Coupe-de-France-de-robotiques/tournament-ggdrive/Rendus/Rapport final info/Asservissement.docx

1. Asservissement
  i. Principe de l’asservissement

Lorsque l’on souhaite faire avancer un robot, on ne peut transmettre à celui-ci qu’une seule consigne. Idéalement, si le système est parfait et que l’on sait exactement une telle tension donne une telle vitesse, une seule consigne peut être suffisante pour avancer le robot. Mais la réalité, en raison de la perturbation et de l’imperfection du système, les erreurs sont sûrement garanties. Afin de résoudre ce problème et de réduire les erreurs produites, il y a besoin d’avoir un retour sur la consigne transmise. On a donc besoin des capteurs pour mesurer la sortie et envoyer le retour, qui permet d’ajuster la consigne correspondant pour corriger les erreurs.

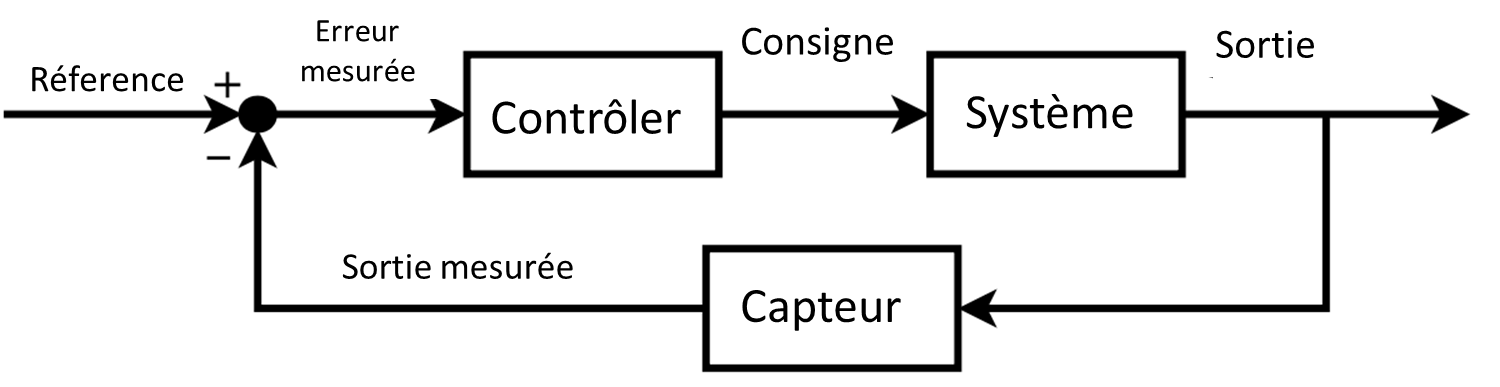
[picture p18: figure]

Figure 1- Pincipe d'un asservissement

Dans notre cas, on souhaite contrôler les deux moteurs du robot avec la carte Arduino et les encodeurs qui permet de mesurer la position du robot. Notre intérêt est de faire avancer le robot tout droit et de faire tourner le robot.

  ii. Présentation des matériels
    a. La carte Arduino

Nous utilisons la carte Arduino MEGA afin d’asservir le déplacement du robot car elle dispose de très nombreux pins d’entrée-sortie. En effet, elle dispose de six pins digitaux qui permettent d’utiliser la fonction « Interrupt » utilisée pour faire tourner tout le temps les encodeurs, alors que l’Arduino UNO ne dispose que deux de ces pins. Il nous donc reste de ces pins pour servir les autres capteurs qui ont besoin.

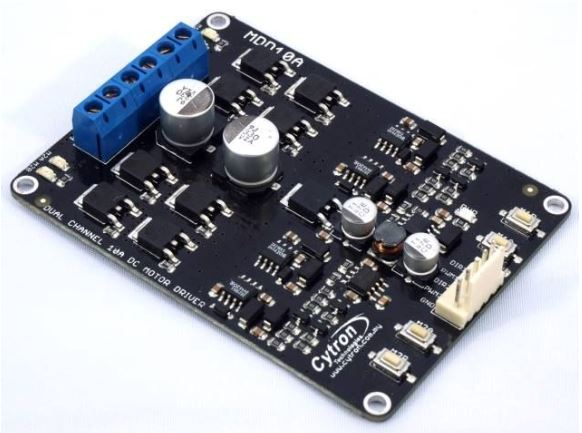
[picture p19: figure]
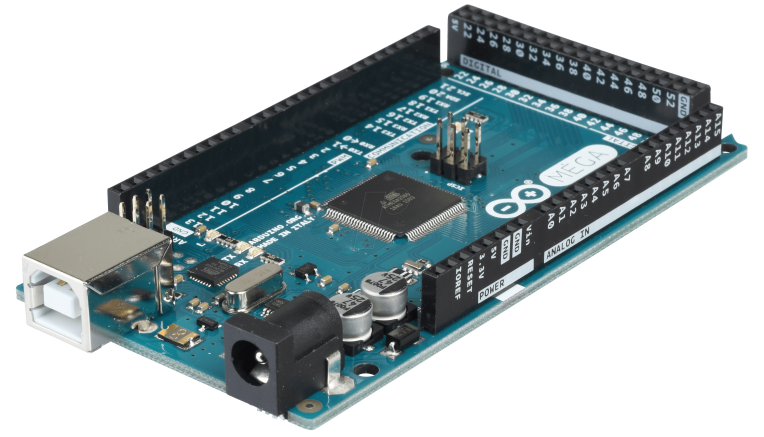
[picture p20: figure]

Figure 2: la carte puissance MDD10A

Figure 3 : Arduino MEGA

On se rend compte d’utiliser la carte Arduino pour réaliser l’asservissement, mais la sortie PWM de l’Arduino de 0 à 5V est très faible pour contrôler le moteur de 12 V. On a donc besoin un circuit intermédiaire pour augmenter la tension sortie et aussi prévenir le courant induit par le moteur. Le circuit mentionné n’a pas été fait car on a trouvé une autre solution plus simple, c’est d’utiliser une carte puissance (MDD10A) de Cytron Technologies (figure 2).

    b. Moteurs

Le bon choix des moteurs est un point important dans la réalisation d'un robot. En effet si les moteurs n'ont pas assez de couple, il sera très difficile pour le robot de se mouvoir à faible vitesse, de démarrer ou même de freiner efficacement. Si la vitesse de rotation est trop faible, le robot sera lent, si le moteur est sous-dimensionné il sera utilisé en surrégime, ce qui peut être bénin pour une utilisation de courte durée comme critique si l'utilisation est en fait trop violente et entraîner la fonte de la gaine du bobinage et donc la destruction du moteur.

Après étudier les caractéristiques du moteur de la marque suisse « Maxon Motors » qui est réputé pour sa robustesse, le groupe Méca a décidé de l’utiliser pour notre robot.

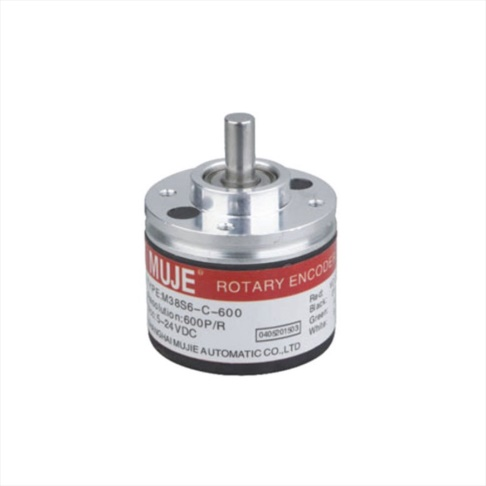
[picture p21: figure]
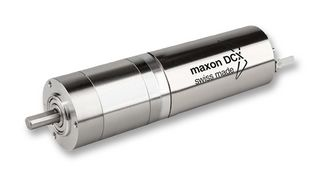
[picture p22: figure]

Figure 4 : Encodeur

Figure 5 : Moteur Maxon

    c. Encodeur séparé

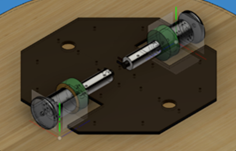
[picture p23: figure]

Pour optimiser l’odométrie, nous avons décidé rapidement de séparer la motricité de l’encodage du mouvement comme la figure ci-dessous pour s’affranchir du compromis adhérence-précision (la roue motrice veut avoir une grande surface de contact tandis qu’une roue codeuse optimale souhaite un contact ponctuel).

Figure 6 : La structure de la base du robot

  iii. Asservissement
    a. Localisation

À part de la caméra, le positionnement peut se faire à partir des encodeurs. C’est le positionnement relatif, on met à jour la position du robot à chaque petit pas du temps, à partir de la position précédente du robot.

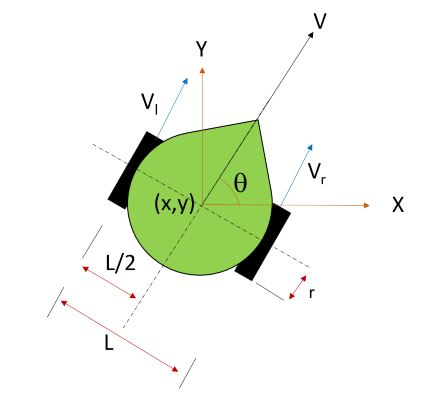
[picture p24: figure]
Capture

Le modèle qu’on a utilisé, c’est le modèle du robot mobile à roues différentielles.

Figure 7 : modèle du robot

{, x=vcos(θ), y=vsin(θ), θ=ω et {, v=1/2(v_r +v_l ), θ=1/L(v_r -v_l )

Il nous donc donne la position et l’orientation du robot par :

{, x(t+Δt)≈x(t)+(dx)/(dt) Δt=x(t)+1/2(v_r +v_l )Δt cos⁡(θ), y(t+Δt) ≈y(t)+(dy)/(dt) Δt=y(t)+1/2(v_r +v_l )Δtsin(θ), θ(t+Δt)≈θ(t)+(dθ)/(dt) Δt=θ(t)+1/L(v_r -v_l )Δt

Comme Δt est petit, v_r Δt et v_l Δt sont le déplacement de la roue droite et gauche respectivement ( d_r , d_l ).

On a donc {, x(t+Δt)=x(t)+1/2(d_r +d_l )cosθ, y(t+Δt)=y(t)+1/2(d_r +d_l )sinθ, θ(t+Δt)=θ(t)+1/L(d_r -d_l )

d_r et d_l = le déplacement par « tick » × un écart de nombre de ticks en Δt

L’implémentation du positionnement du robot n’est pas très compliquée, il suffit de mettre à jour les équations à chaque petit pas du temps.

    b. Implémentation du PID

Notre asservissement est un asservissement en position, en effet, nous ne cherchons pas à contrôler la vitesse de déplacement du robot mais uniquement sa position afin qu’il parcoure exactement la distance souhaitée en ligne droite et qu’il tourne exactement vers l’orientation souhaitée.

Le principe du PID (Proportionnel, intégrale, dérivée) est de comparer à la fois la sortie et l’entrée (reference) afin d’observer l’évolution de l’erreur et de le corriger avec la consigne qui est formée par trois composantes :

- Composante proportionnel : elle génère une valeur proportionnelle aux erreurs mesurées. Si l’erreur est importante, il faut aussi appliquer une correction importante afin de converger vers la valeur voulue. Mais quand on demande plus de rapidité (composante proportionnel est grande), le système est sensible à l’oscillation et il ne converge pas vers la valeur voulue.
- Composante dérivée : elle permet d’améliorer la stabilité du système en diminuant les oscillations. En effet, elle donne une valeur proportionnelle à l’évolution de l’erreur au cours du temps.
- Composante intégrale : elle permet de gagner en précision en empêchant la formation d’une erreur statique. Lorsqu’il n’y a pas de changement de l’erreur au cours du temps, les composantes proportionnelle et dérivée donnent uniquement zéro. Afin d’éviter ce phénomène, la somme des erreurs au cours du temps nous permet de pousser la convergence du système vers la valeur voulue.

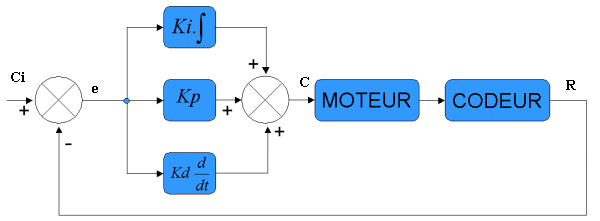
[picture p25: figure]

Figure 8 : Schéma PID

Comme indiqué plus haut, le modèle du robot nous donne :

{, v=1/2(v_r +v_l ), ω=1/L(v_r -v_l ) ou bien {, v=r/2(ω_r +ω_l ), ω=r/L(ω_r -ω_l )

ω_r et ω_l sont la vitesse angulaire du moteur droite et gauche.

On a donc {, ω_r =1/r(2v+Lω) , ω_l =1/r(2v-Lω)

À partir de ces équations, les consignes envoyées au moteur droite et gauche sont déterminées par la vitesse de déplacement et la vitesse angulaire du robot.

- Pour faire tourner le robot à l’angle souhaité, la vitesse de déplacement du robot doit être zéro. Il ne nous reste que de gérer la vitesse angulaire.

C’est à partir d’ici, on va implémenter le PID. On va suivre ces étapes :

  - Mesurer l’orientation du robot
  - Mesurer l’erreur en angle par rapport à l’angle désiré
  - Former une correction de trois composantes

ω= K_p erreurAngle+K_d (d(erreurAngle))/(dt)+K_i ∫erreurAngle(t)dt

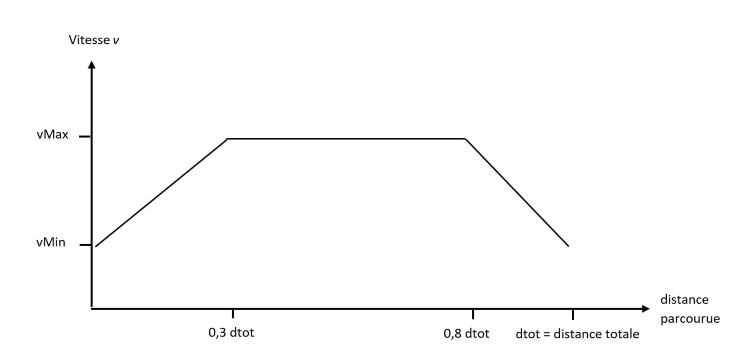
[picture p26: figure]

- Pour faire avancer le robot en ligne droite, l’orientation du robot doit être zéro ; ω est déterminée par le PID de l’angle souhaité zéro. Cependant, la vitesse de déplacement est déterminée de la manière indiquée dans la figure ci-dessous, elle augmente en rampe au début, descend en rampe à la fin et reste constant au milieu du trajet.

Figure 9 : la fonction de vitesse au cours du temps

Réglage des constantes K_p , K_d , K_i

On va se servir la méthode de Ziegler-Nichols pour régler les constantes du PID. Afin d’obtenir K_p , K_d ,K_i , il nous faut d’abord cherche le gain maximal K_u en mettant K_i et K_d en zéro et en réglant K_p jusqu’à ce que le système s’oscille de manière stable. Ensuite, on repère la période d’oscillation T_u . On a donc le réglage correspondant :

{, K_p =0,6K_u , K_d =3K_u T_u /40, K_i =1,2K_u /T_u
