Coupe-de-France-de-robotiques/tournament-ggdrive/Rendus/Presentation finale info/Document sans titre.docx

Organigramme

Pourquoi Arduino + raspberry ?

Organisation du robot

Choix de l’algo (Demo)

Cam (demo)

Asservissement (demo)

Conclusion

Guillaume

Kim hong

Aurélien

Ayoub
