Coupe-de-France-de-robotiques/tournament-ggdrive/Rendus/Presentation finale info/Présentation sans titre.pptx

## Choix des cartes

1 carte Arduino reliée au cœur du robot
2 cartes Raspberry Pi : une dans le robot, l’autre reliée à la caméra

## Pourquoi Arduino ?

Pratique à utiliser
Facile d’interagir avec les autres composants
Adapté à la robotique

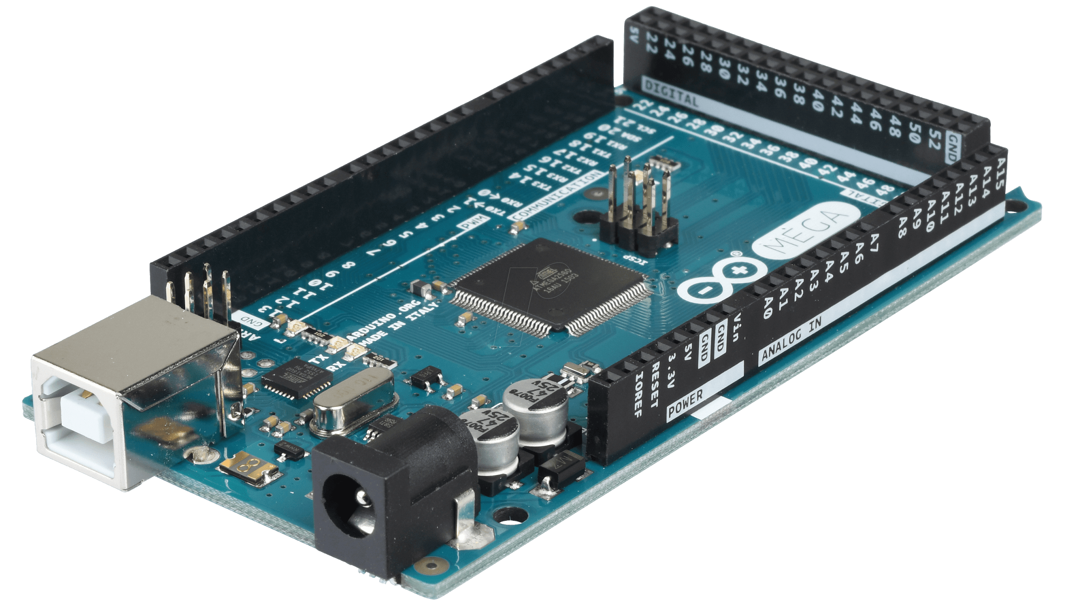
[picture p40: figure]

## Pourquoi Raspberry Pi ?

Calculs lourds et en parallèle
Compatibilité de caméra
Communication inter-cartes

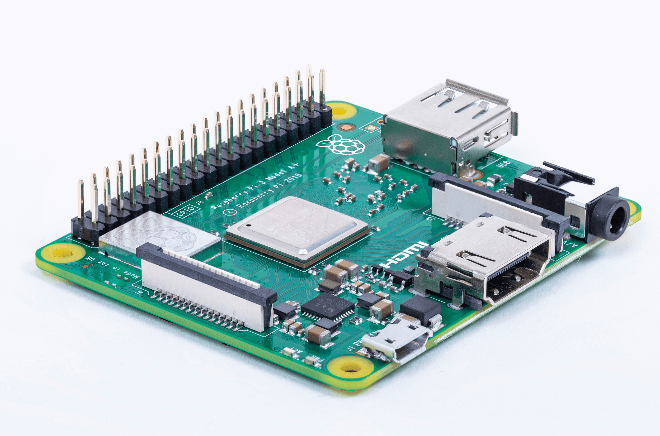
[picture p41: figure]

## Organisation du robot

Robot

Bloc caméra

Raspberry Pi

Caméra

Arduino

Raspberry Pi

Moteurs

Roues encodeuses

Capteurs ultrasons

## Conclusion
