Coupe-de-France-de-robotiques/tournament-ggdrive/Rendus/Rapport final info/Plan.docx

Total de pages: entre 30 et 40

Nombre de pages à titre indicatif (essayez d’en faire au moins les ⅔), sans les images.

Par ailleurs, la notation prend en compte les références bibliographiques ; si vous pouvez indiquer où une référence est utilisée dans votre texte, c’est positif.

Intro 1 page

Présentation du groupe & organisation 2 pages Aurélien

Exotec 6 pages Aurélien

Robot 1 page (à pomper sur la méca)

Cerveau 10 pages Ayoub

Asservissement 5 pages Kimhong

Caméra 5 pages Guillaume

Conclusion 1 page

Références & remerciements balancez tout
