Coupe-de-France-de-robotiques/tournament-ggdrive/Ressources - matériel/Ressources.docx

Au niveau de ce qu’on a utilisé et sur quoi vous pouvez vous pencher:

- Partie info
  - Cartes arduino, c’est assez facile à utiliser, on apprend les bases assez vite et on trouve beaucoup de doc pour tout ce dont on a besoin. Pour commencer par quelque-chose, vous pouvez regarder le tuto https://openclassrooms.com/courses/programmez-vos-premiers-montages-avec-arduino
  - Raspberry pi : Si vous voulez faire un robot plus intelligent, c’est un passage obligé. La raspberry c’est un ordinateur complet sur une seule carte, et ça tourne sous Linux. Pour pouvoir utiliser ça il y a pas 36 solutions, il faut maîtriser Linux. À tout le groupe qui s’occupe de l’info, je vous recommande très fortement de suivre ce tuto (en entier si possible) https://openclassrooms.com/courses/reprenez-le-controle-a-l-aide-de-linux/mais-c-est-quoi-linux Si vous voulez faire un peu d’info plus tard (que ça soit en parcours info, map, méca ou autre…) vous en aurez besoin, c’est un passage obligé. C’est pas trés dur il faut juste prendre un peu l’habitude, pour ça je vous recommande de faire un dual boot, c’est très pratique mais si vous préférez vous pouvez juste utiliser une machine virtuelle (voir tuto). Je vous conseille d’utiliser ROS, on a pas eu l’occasion de s’y pencher mais c’est vraiment top, on me l’a conseillé à de nombreuses reprises :https://fr.wikipedia.org/wiki/Robot_Operating_System ou encore http://wiki.ros.org/ Pas besoin de regarder ça tout de suite, ça peut attendre la rentrée, commencez par Linux ^^
  - Git, c’est un outil de versionning, ça permet de travailler sur un projet informatique à plusieurs. C’est vraiment un standard qu’on utilise partout (même si il en existe d’autre). Pareil, commencez par Linux, on verra ça plus tard.
- Partie méca
  - Pour tout ce qui est modélisation, Fusion 360 est pas mal. Contrairement à Solid Works, c’est facile d’avoir une licence gratuite en étant étudiant (https://www.autodesk.com/products/fusion-360/students-teachers-educators?td=aexfusion&displ=1). Essayez de commencer à prendre le logiciel en main, à regarder quelque tutos et à essayer de faire des formes (genre, modélisez votre lampe de bureau par exemple)
  - Il faut absolument faire la formation machine (découpe laser et imprimante 3D) c’est vos outils principaux pour construire le robot.
  - Quand vous avez besoin de matos (à condition d’avoir le budget…) cherchez du côté de robotshop: https://www.robotshop.com/eu/fr/ de RS https://fr.rs-online.com/web/ (c’est chez eux qu’il faut regarder pour les commandes avec le Fablab, qui donne un peu d’argent chaque année). Ou encore chez Amazon
- Bricolage de manière générale (édit Maxime Escande)
  - https://www.youtube.com/user/monsieurbidouille chaîne Youtube qui explique les différents logiciels de modélisation 3d, l'impression 3d, ...
