Coupe-de-France-de-robotiques/tournament-ggdrive/Rendus/Prés Prop Dét/Présentation Proposition détaillée.docx

!!!!!!!!!J’ai mis une version avec trois slides en plus en pptx à côté mais je ne sais pas comment refaire le coup du document en ligne comme yahia avait fait (Pour toute réclamation sur le fait que l’on ne puisse plus modifier le document à plusieurs, ben faut le remettre en ligne mais je ne sais vraiment pas comment…(Julien) )

https://epolytechnique-my.sharepoint.com/:p:/g/personal/yahya_iben-brahim_polytechnique_edu/EbK5ZoKXDBFKoMHUUOfnzHgBao6ZR1P9KX-HfSzw_p0nxA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
