Coupe-de-France-de-robotiques/tournament-ggdrive/Rendus/Prés Prop Dét/PrésentationPropDét.pptx

## PROJET SCIENTIFIQUE COLLECTIF


PROPOSOTIon detailleÉ

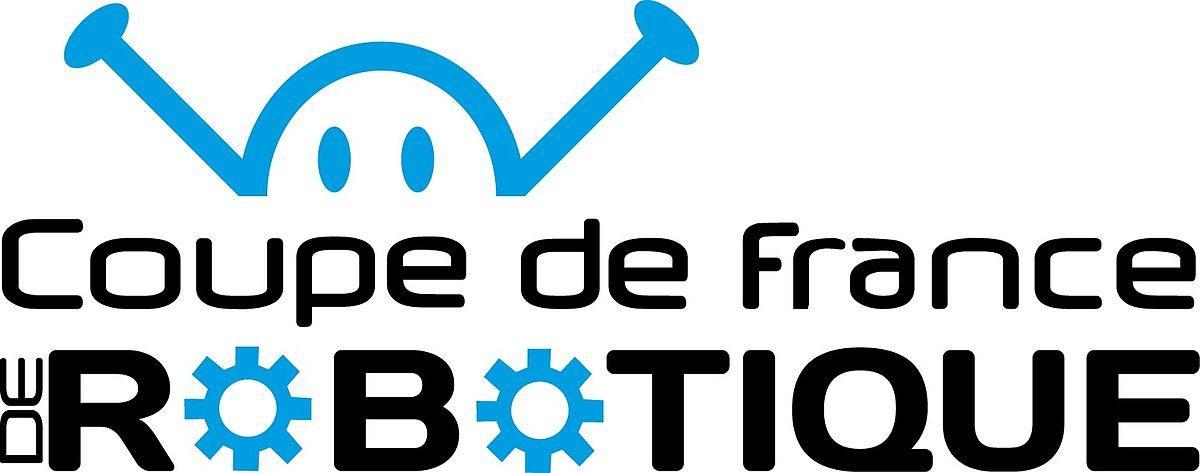
[picture p57: figure]
Une image contenant graphiques vectoriels Description générée avec un niveau de confiance élevé

## Groupe mec 11

- AGIER Julien
- COLSON Raphaël
- CHAQUIQ ELBADRE Hamza
- ESCANDE Maxime
- IBEN BRAHIM Yahya
TUTEUR: SOUVESTRE Florent
COORDINATEUR: BODELOT Laurence

En collaboration avec le groupe INF 09

## Sommaire

- 1) Présentation du Projet
- 2) Enjeux et motivation
- 3) Règlement de la coupe
- 4) Organisation
- 5) Avancement et planning prévisionnel
- 6) Moyens et financement

## 1) PROJET

- Coupe de France de robotique : Mai 2019
- Thème 2019 : ATOM FACTORY
- Conception et réalisation d'un robot capable de marquer le maximum de points.

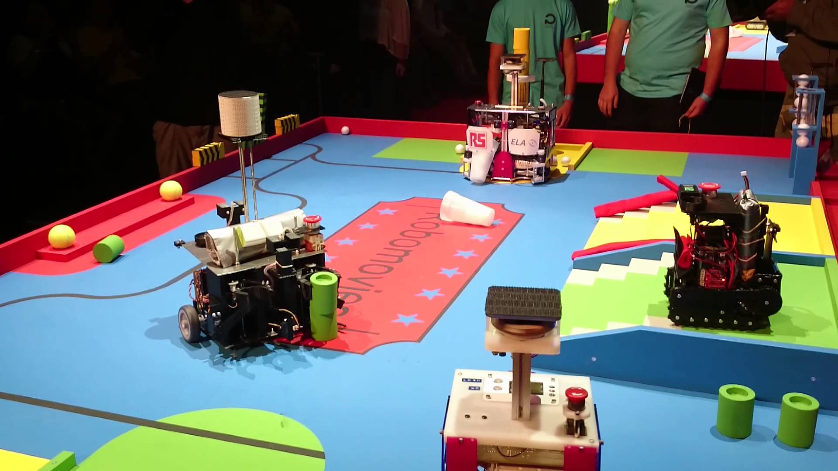
[picture p58: figure]
Une image contenant intérieur, table, gâteau, personne Description générée avec un niveau de confiance élevé

## 2) Enjeux et motivation

- Suivre une démarche industrielle

- Objectif du groupe: réalisation d'un robot transmissible aux générations futures :
    - Base mobile fiable
    - Actionneurs modulables

Cahier de charges
Reformulation technique
Répartition en pôles

- Projet concret et ludique

## 3) RÈGLEMENT DE LA COUPE 2019

- L'aire de jeu
- Les éléments du jeu : les Atomes
- Missions Atom Factory
- Notre stratégie

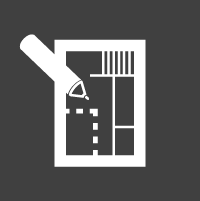
[picture p59: figure]

## L'aire de jeu

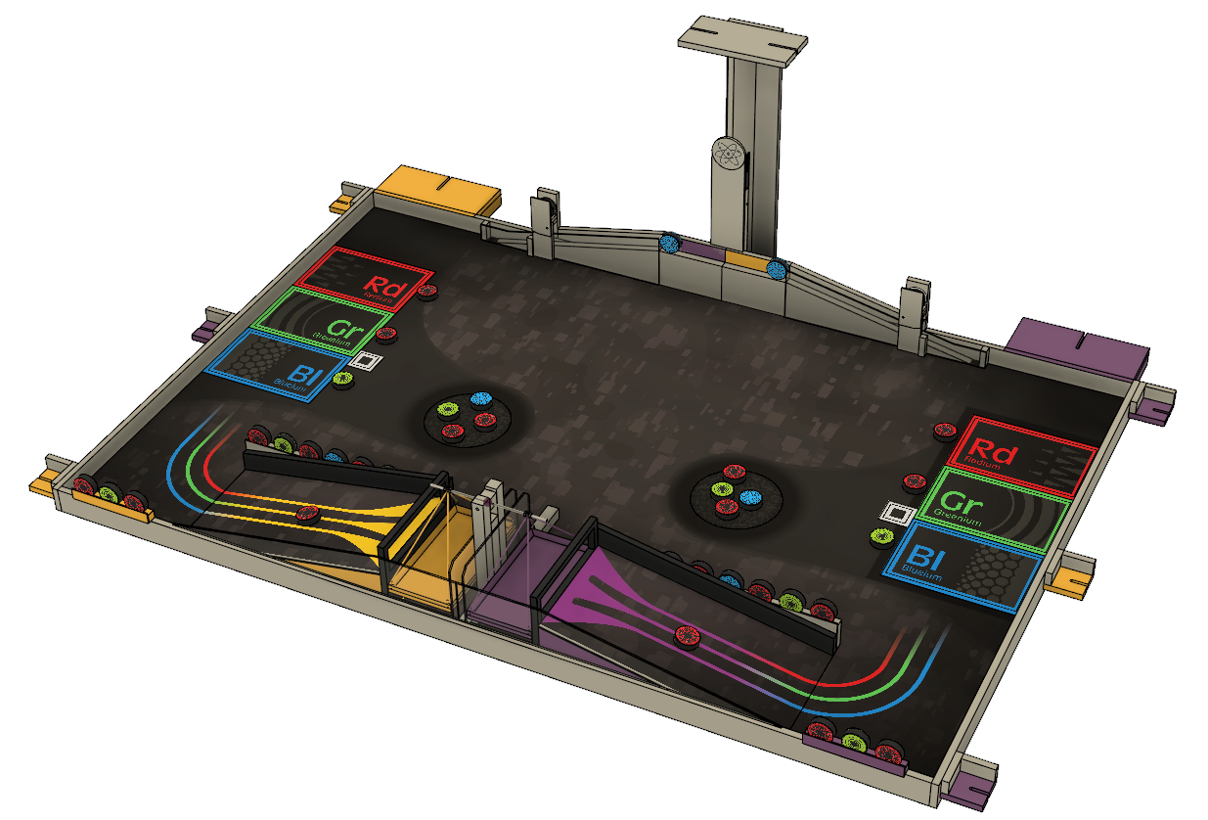
[picture p60: figure]
Une image contenant intérieur, assis Description générée avec un niveau de confiance très élevé

## Les éléments du jeu : les Atomes

Les atomes sont représentés par des palets de hockey

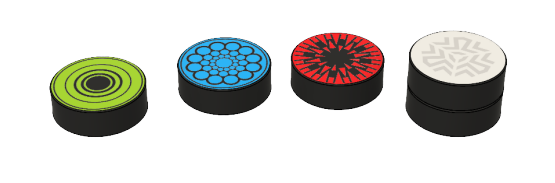
[picture p61: figure]
Une image contenant casino, pièce Description générée avec un niveau de confiance très élevé

Blueium 170g

Redium 60g

Goldenium 340g

Greenium 120g

## Missions Atom Factory

- Classer les atomes
- Peser les atomes
- Créer un nouvel élément
- Faire sa propre expérience
- Prédire les éléments non connus

## Notre stratégie

- Tâche principale : base mobile fiable
- Choix des missions les plus simples qui rapportent le plus de points :
- L'exprérience
- Créer un nouvel élément (récupérer le goldenium)
- Prédir le score
- Missions secondaires : classer les atomes.

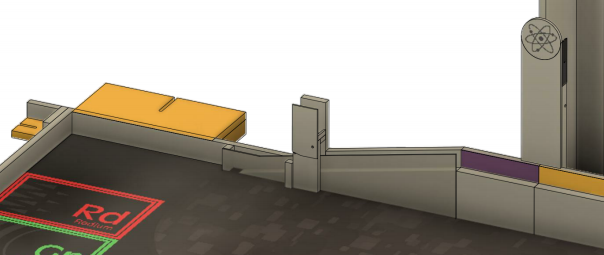
[picture p62: figure]
Une image contenant plancher, intérieur, meubles, mur Description générée avec un niveau de confiance très élevé
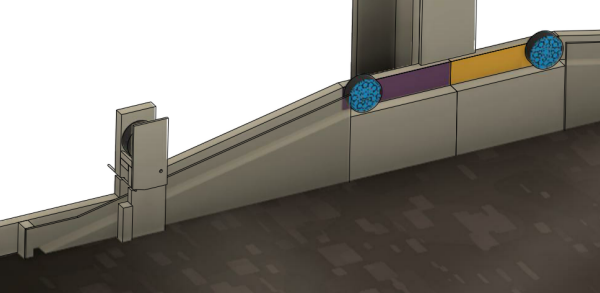
[picture p63: figure]
Une image contenant plancher, intérieur, mur, ciel Description générée avec un niveau de confiance très élevé

## 4) Organisation

Structure 3D

Maxime
Coordinateur

Dimensionnement et motorisation

Julien
Resp. Administratif
Hamza
Secrétaire général

Capteurs

Yahya
Trésorier
Raphaël
Resp. sponsors

## Dimensionnement et motorisation

- v_(min) = 0.5 m/s atteignable en 1s
Avec m≈6kg , R_w ≈4cm
C_w ≥maR=1,2 10^(−1) Nm
ω_w ≥v/R=1,9 2π rad s^(−1)
- Compromis moteur réducteur ( σ ratio) :
C_w ω_w =C_m ω_m
σ=(ω_w)/(ω_m)

## Précision d’encodage

  - Rotation de θ et avancée de L
  - ε(L)=2dL=2Ru(α)
  - ε(θ)=Lu(θ)≈R/l Lu(α)θ
θ=R/lα, so (u(θ))/θ=√((α/R)^2 u(R)²+((Rα)/(l^2))^2 u(l)²+(R/l)^2 u(α)²)
→Grand déplacement, l’erreur vient des rotations
  - Déplacement type de la coupe : 2m et demi-tour cinq fois
  - Erreur inférieure à 5cm si:
u(α)≈5/5 15/(3∗200∗π)=2π 1/400

## Choix structurels

- Une structure simple et fiable
- appuie ponctuel dilemme précision /accélération

Avant

Roues motrices

Arrière

Roues encodeuses

Roues libres : asssurent la stabilité

## Dimensionnement et motorisation

- CALCUL
- EQUATION
- CALCUL
- EQUATION

## 5) Avancement et planning prévisionnel

Sortie des règles

Aujourd'hui
Proposition détaillée

Budget et commandes

Robot modélisé
et étude d'asservissement

mise en commun groupe inf

sep

oct

Règles définitives

nov

Aire de jeu construite

dec

jan

Structure prête

Test 1 : asservissement et odométrie

Actionneur et "l'expérience" achevés

Test 2 : homologation

Coupe de robotique

fev

Rapport intermédiaire

mar

avr

Rapport final

mai

## 6) Moyens et financement

- Sponsorisation par Exotec Solutions à condition que nous suivions la méthode de l'entreprise
- Nous sommes libre pour tous les choix techniques
- Validation de :
- 15 février 2019: Test de positionnement sans obstacles
- 10 avril 2019: Test d'homologation

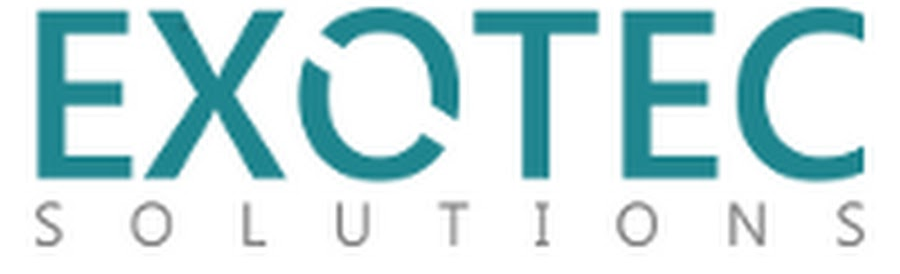
[picture p64: figure]
