Coupe-de-France-de-robotiques/tournament-ggdrive/Rendus/PSC/Organigramme.pptx

Binet X-Robots Président : Yahya
Trésorier : Guillaume Pelat (INF 09)

Coupe de France de Robotique Référent : Raphaël

PSC MEC 11 : Pôle mécanique

Partie support

Partie opérationnelle

PSC INF 09 :
Pôle informatique

Relations extérieures
Raphaël

Matériel
Julien

Trésorerie
Maxime

Lien méca – info :
Guillaume Maxime

Modélisation 3D
Julien
Maxime

Performance
Raphaël
Yahya

Capteurs
Hamza
Raphaël

Motorisation
Julien
Yahya

Table d’essais
Hamza
Yahya
