Coupe-de-France-de-robotiques/tournament-ggdrive/Rendus/Presentation finale info/Présentation sans titre(1).pptx

## Choix de l’algorithme

## Rappel

- Structures de données
- Implémentation:
  - mise à jour de la table
  - communication avec l’Arduino
  - gestion des obstacles
- Tests

## Calcul du chemin minimal

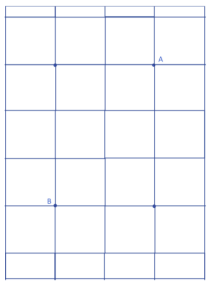
[picture p82: figure]
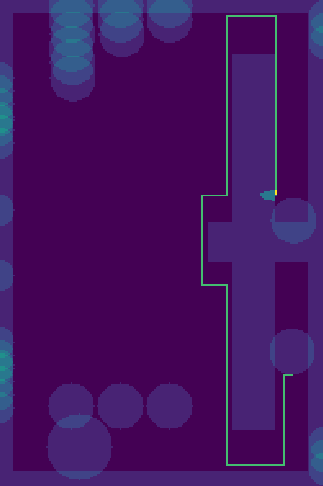
[picture p83: figure]

- Problématiques :
- calcul chemin en temps réel
- chemin avec peu de virages
- optimalité temporelle (zones vides)
- Solutions envisagées
- Algorithme A*
- réduction de la résolution

## Demo & limites de l’algorithme

- Demo (obstacles / astar / paramètres)
- Blocage du robot entre obstacles
- Nécessité de la fonction grab() et put()
- Atoms bougés par l’autre robot (100ms)

## Asservissement

## Slide 6
