Coupe-de-France-de-robotiques/tournament-ggdrive/Equipe Polytechnique Coupe 2019.jpg

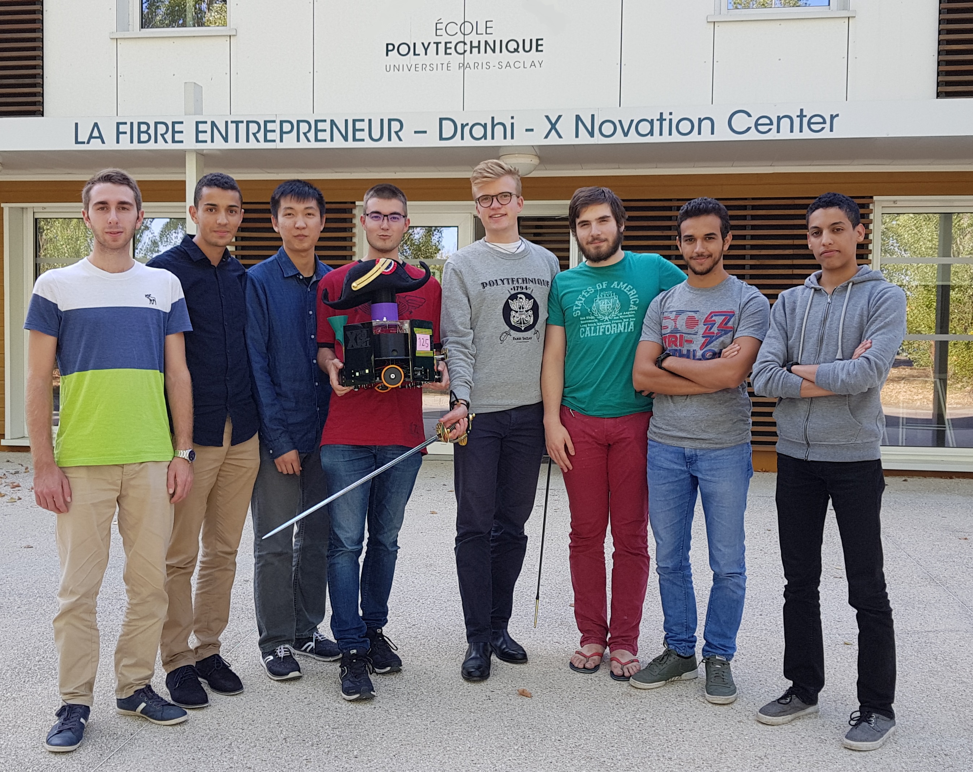
Equipe Polytechnique Coupe 2019.jpg
