Coupe-de-France-de-robotiques/tournament-ggdrive/Photos/IMG_20190410_142839.jpg

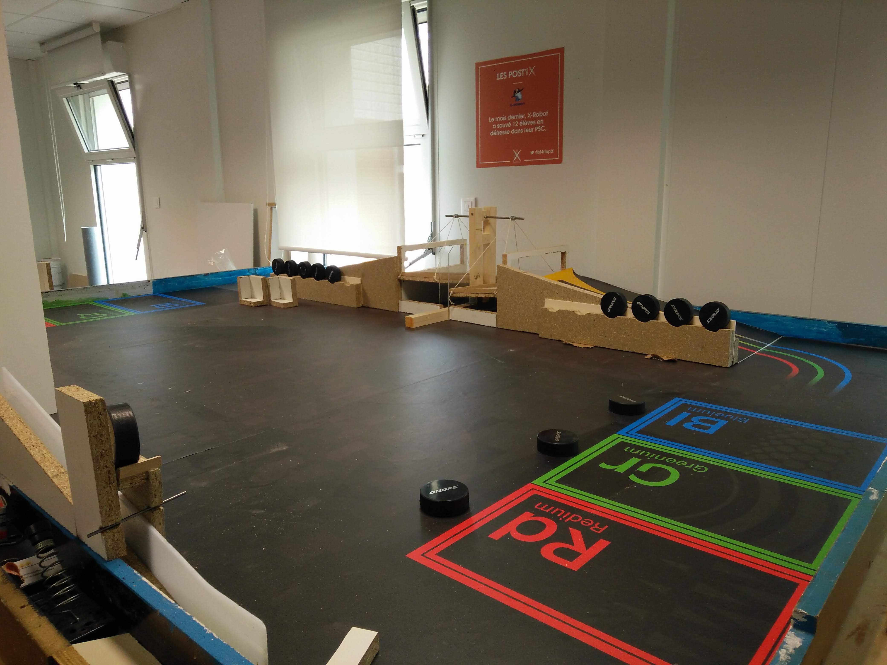
Photos/IMG_20190410_142839.jpg
