Coupe-de-France-de-robotiques/tournament-ggdrive/Photos/IMG_20190410_142941.jpg

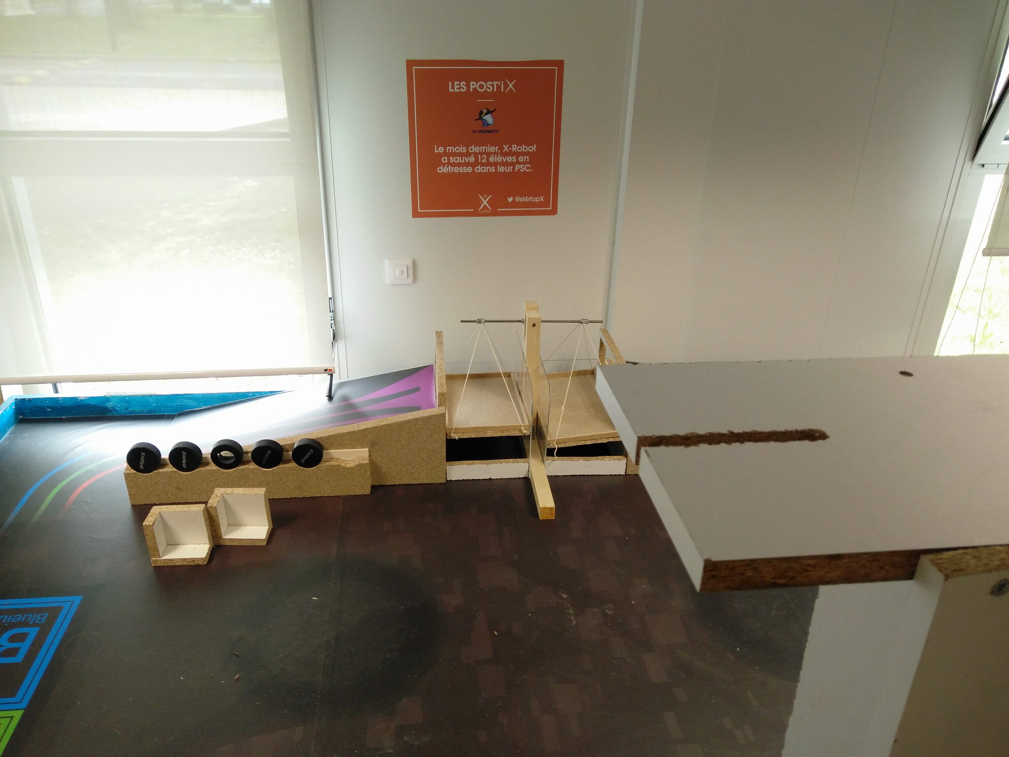
Photos/IMG_20190410_142941.jpg
