Coupe-de-France-de-robotiques/tournament-ggdrive/Photos/IMG_20190410_143113.jpg

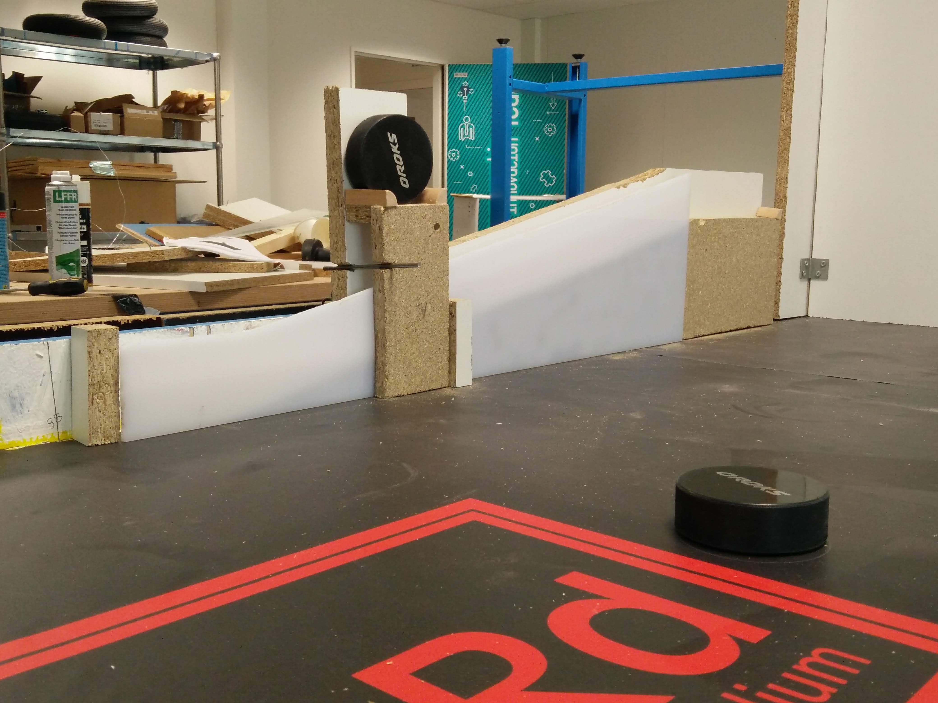
Photos/IMG_20190410_143113.jpg
