Coupe-de-France-de-robotiques/tournament-ggdrive/Rendus/PSC/images/archi.jpg

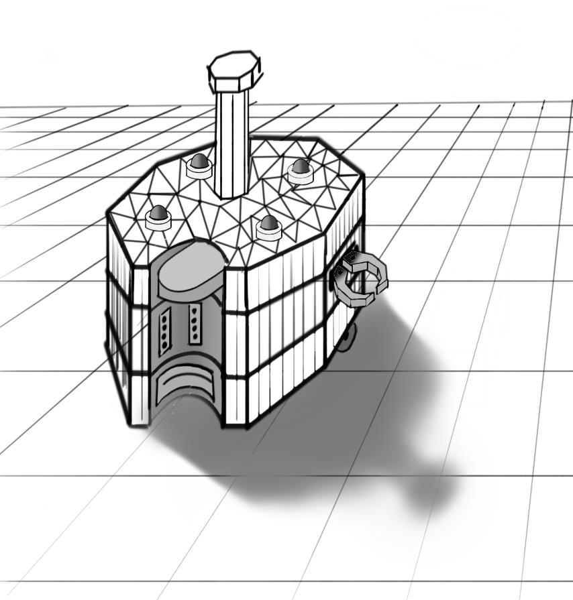
Rendus/PSC/images/archi.jpg
