Coupe-de-France-de-robotiques/tournament-ggdrive/Rendus/PSC/images/Architecture.png

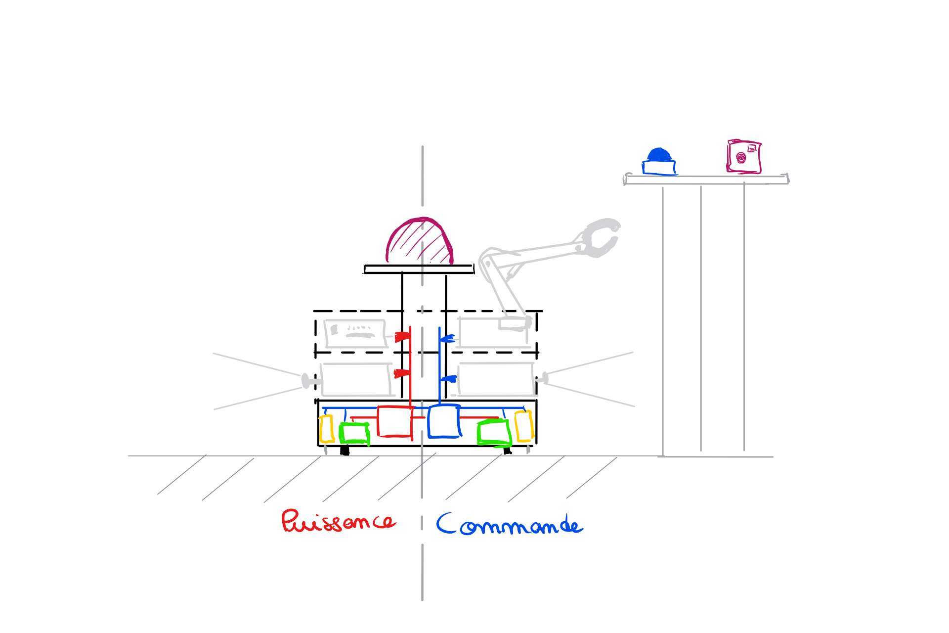
Rendus/PSC/images/Architecture.png
