Coupe-de-France-de-robotiques/tournament-ggdrive/Rendus/PSC/images/baseRoulante.png

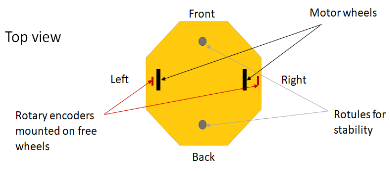
Rendus/PSC/images/baseRoulante.png
