Coupe-de-France-de-robotiques/tournament-ggdrive/Rendus/PSC/images/bride charniere.png

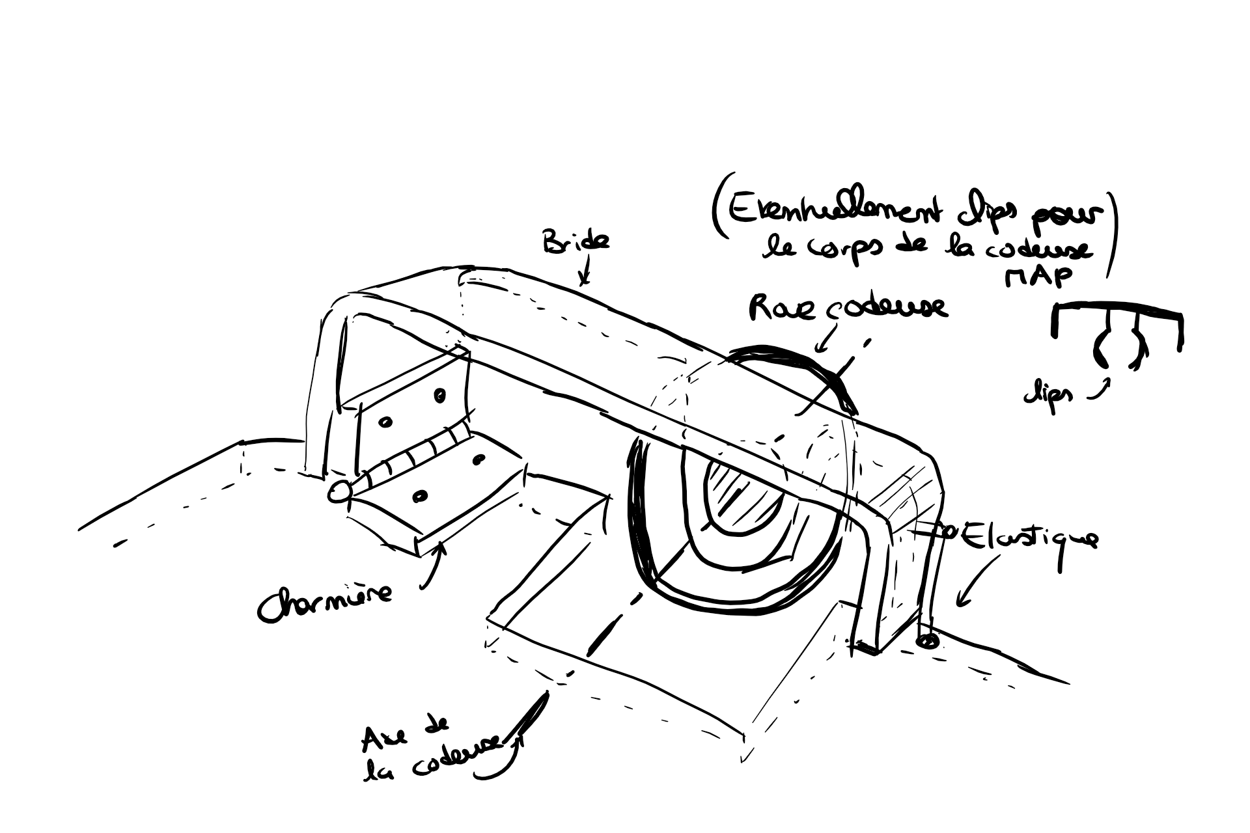
Rendus/PSC/images/bride charniere.png
