Coupe-de-France-de-robotiques/tournament-ggdrive/Rendus/PSC/images/bride codeuse.jpg

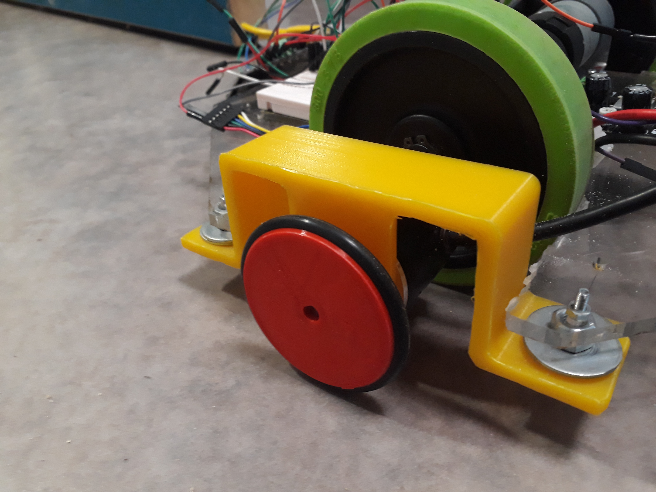
Rendus/PSC/images/bride codeuse.jpg
