Coupe-de-France-de-robotiques/tournament-ggdrive/Rendus/PSC/images/bride moteur.png

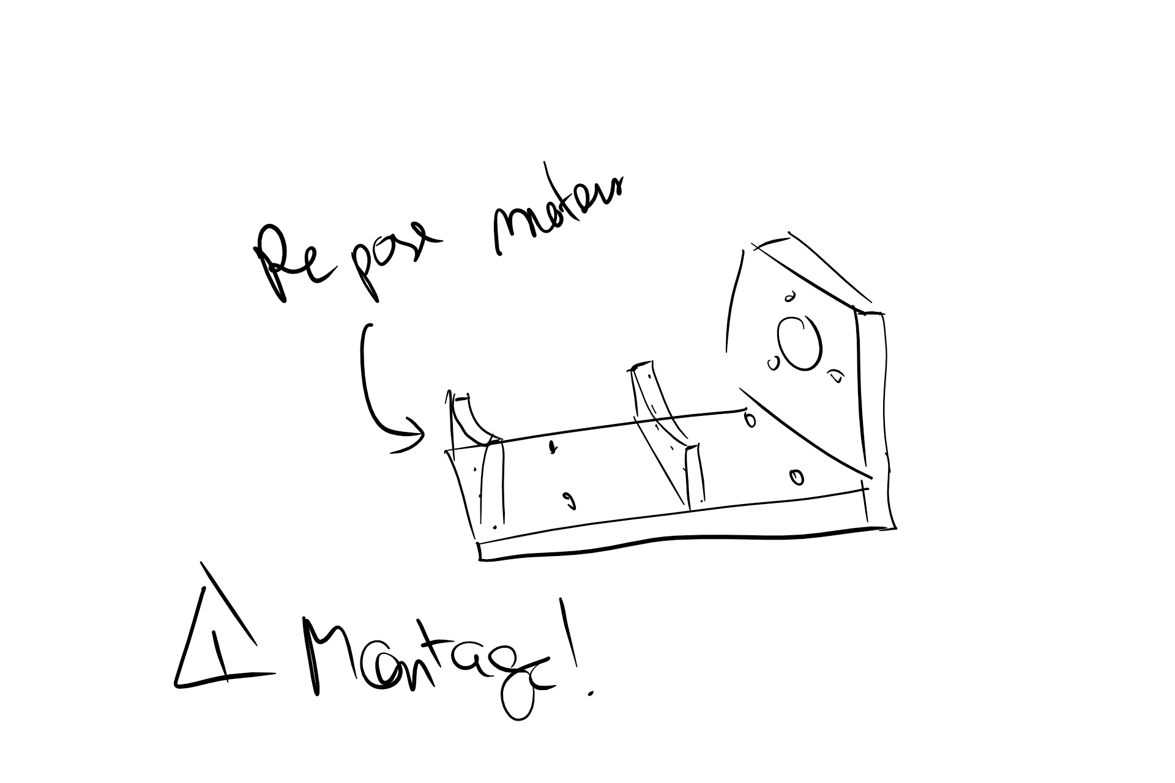
Rendus/PSC/images/bride moteur.png
