Coupe-de-France-de-robotiques/tournament-ggdrive/Rendus/PSC/images/bride.png

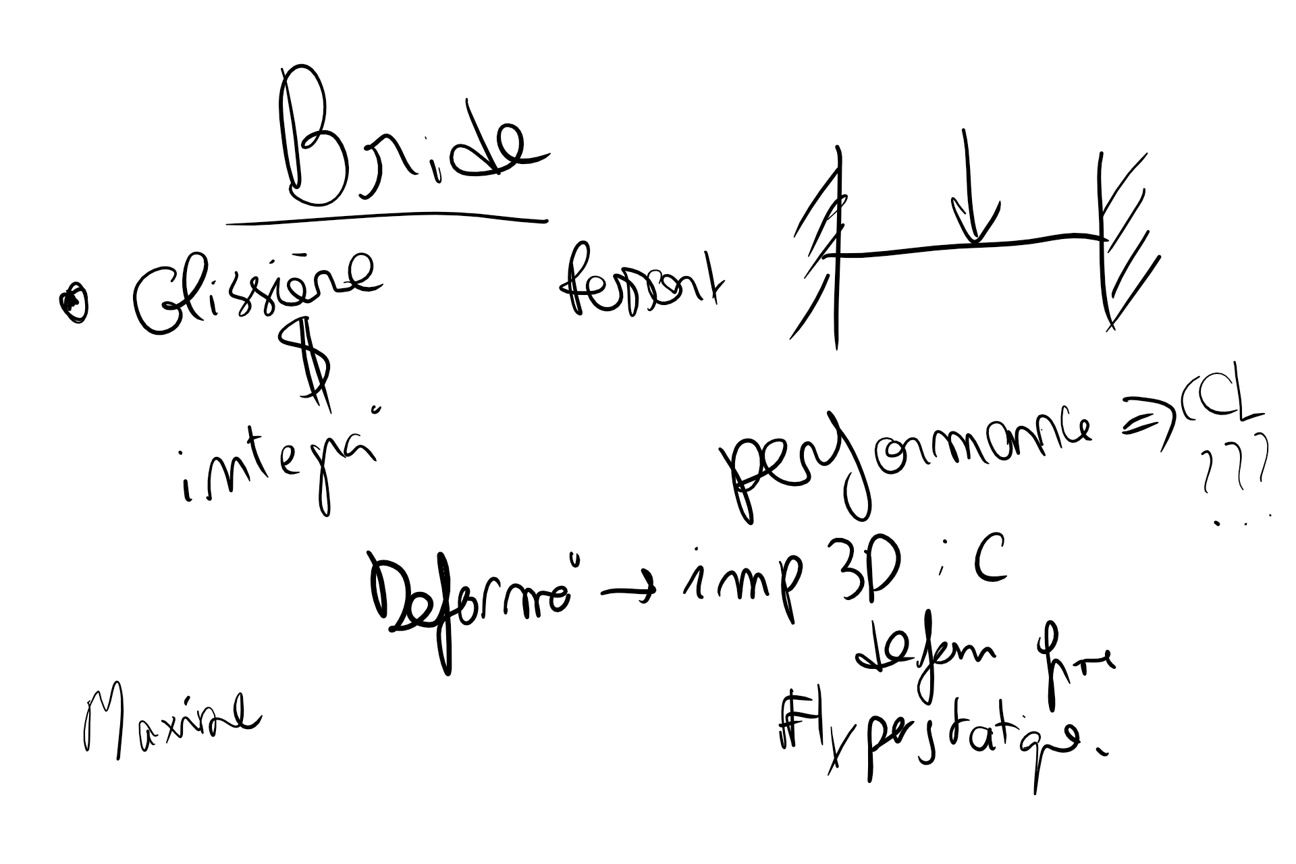
Rendus/PSC/images/bride.png
