Coupe-de-France-de-robotiques/tournament-ggdrive/Rendus/PSC/images/brideCodeuse.png

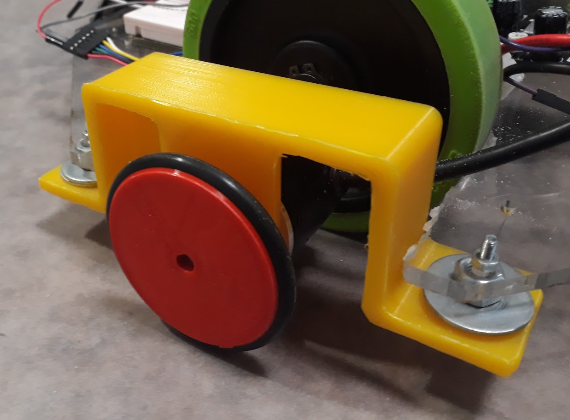
Rendus/PSC/images/brideCodeuse.png
