Coupe-de-France-de-robotiques/tournament-ggdrive/Rendus/PSC/images/choixMoteur.png

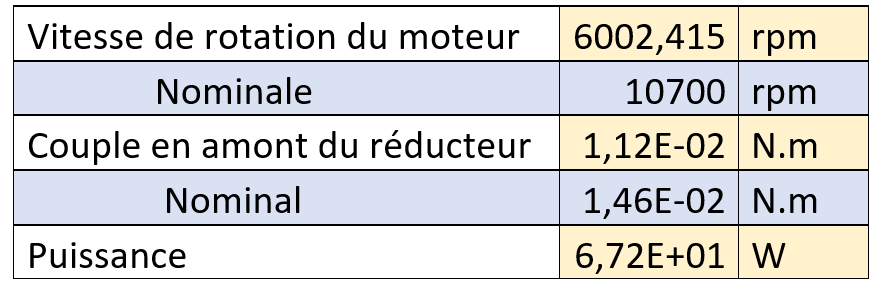
Rendus/PSC/images/choixMoteur.png
