Coupe-de-France-de-robotiques/tournament-ggdrive/Rendus/PSC/images/Design robot.jpg

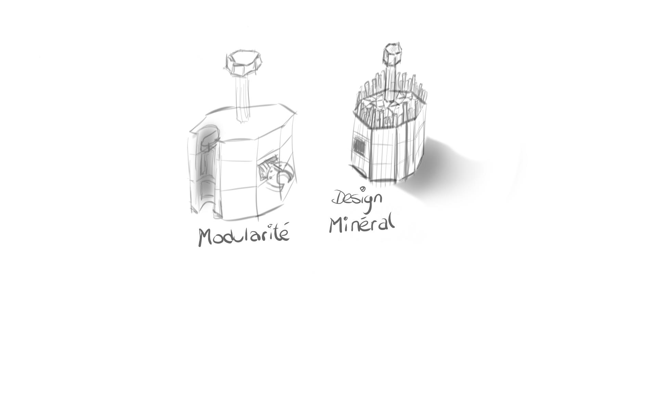
Rendus/PSC/images/Design robot.jpg
