Coupe-de-France-de-robotiques/tournament-ggdrive/Rendus/PSC/images/futur.jpg

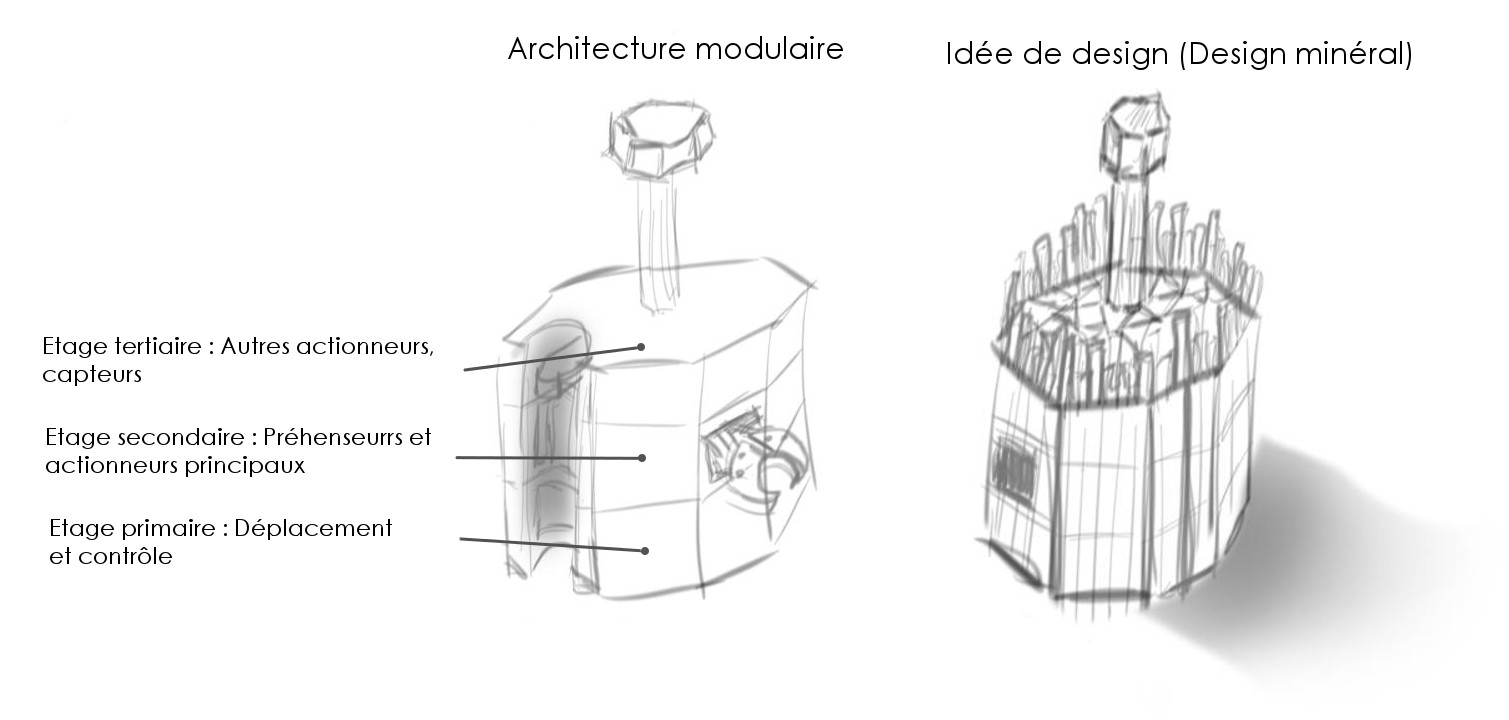
Rendus/PSC/images/futur.jpg
