Coupe-de-France-de-robotiques/tournament-ggdrive/Rendus/PSC/images/glissement.png

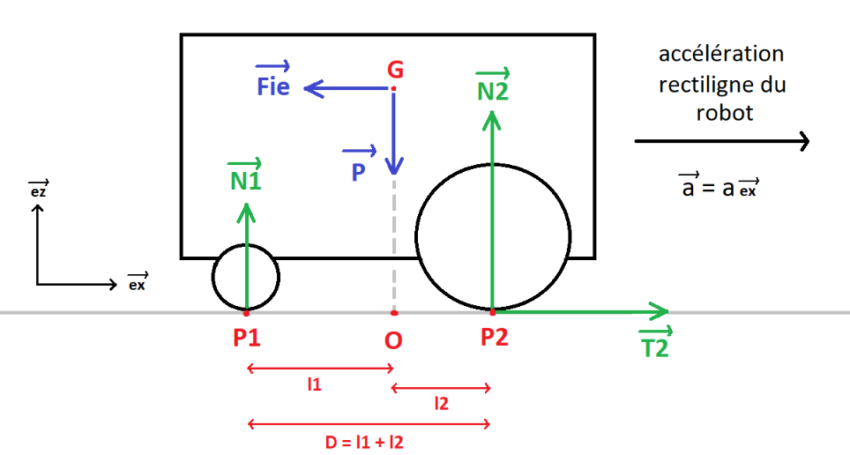
Rendus/PSC/images/glissement.png
