Coupe-de-France-de-robotiques/tournament-ggdrive/Rendus/PSC/images/grapheMoteur.png

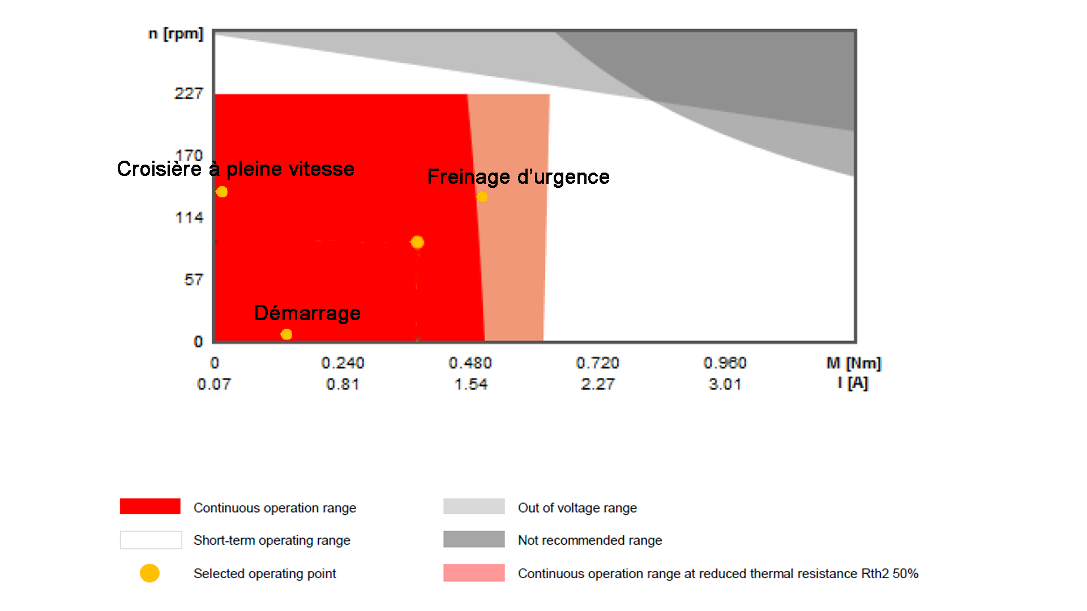
Rendus/PSC/images/grapheMoteur.png
