Coupe-de-France-de-robotiques/tournament-ggdrive/Rendus/PSC/images/orga.jpg

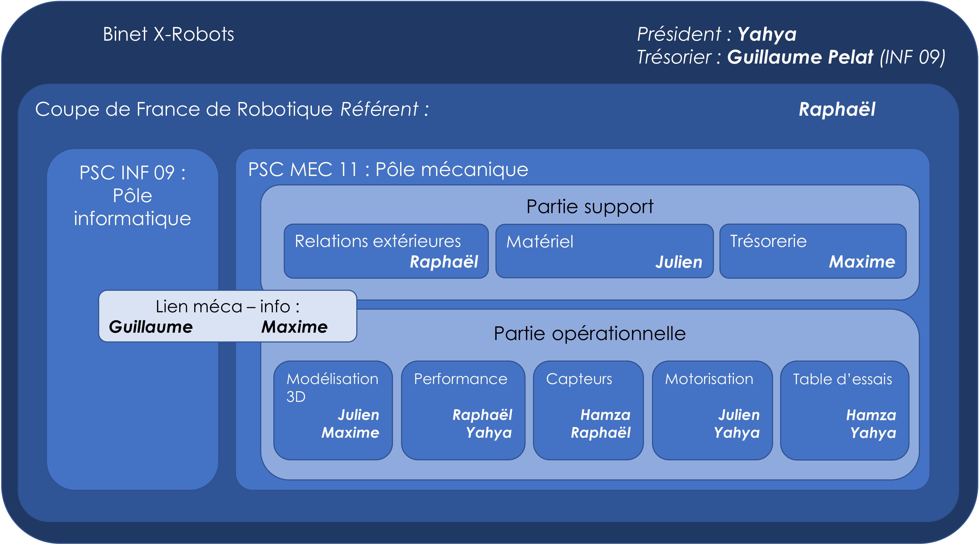
Rendus/PSC/images/orga.jpg
