Coupe-de-France-de-robotiques/tournament-ggdrive/Rendus/PSC/images/pwm.png

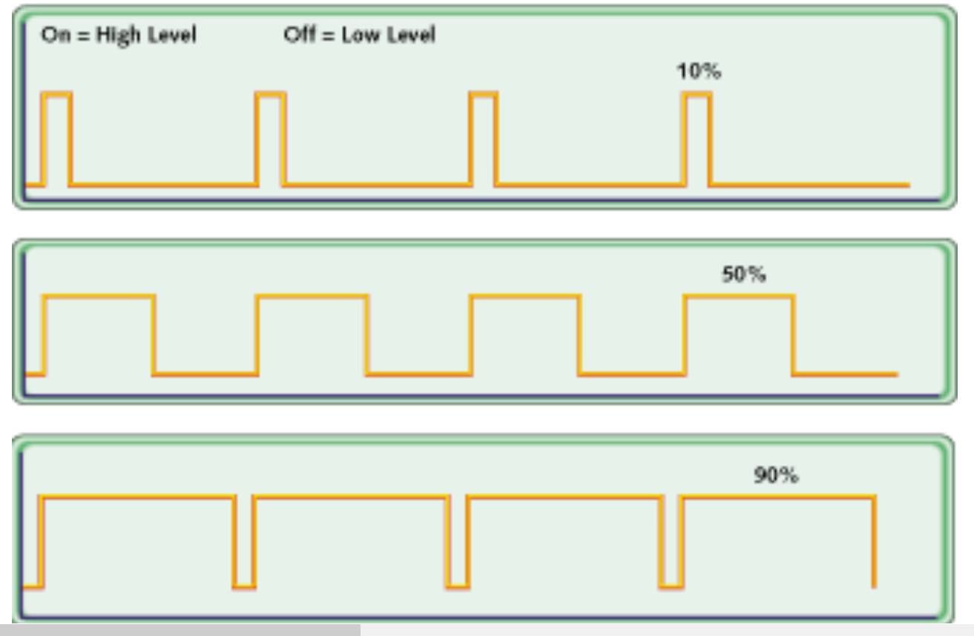
Rendus/PSC/images/pwm.png
