Coupe-de-France-de-robotiques/tournament-ggdrive/Ressources - matériel/Matériel/Aire de jeu/Matériaux par dimension.xlsx

 | Plaques de bois |  |  |  |  |  | Plexiglas | Plexiglas
 | Epaisseur 5mm | 15 x 3000 (min 422 par planche) | 2 de 400x792 | 2 de 80x155 | 2 de 40x300 | 2 de 110x600 | 2 de 422x275 | 2 de 750x205
 | Epaisseur 15mm | 2 de 220x422 | 2 de 80x165 | 2 de 35x80
 | Epaisseur 22mm | 300x800 | 2 de 400x260 | 3 de 145x760 | 4 de 50x225 | 2 de 135x685 | 2 de 80x195 | 2 de 30x70 | 2 de 22x80 | 200x400 | 2 de 200x1000 | 6 de 122x122 | 6 de 48x100 | 6 de 48x122
 | Epaisseur 30mm | 2 de 150x950 | 200x450 | 2 de 40x170 | 40x450 | 2 de 30x300 | 2 de 100x600
 | Plaques de plexiglas
 | Epaisseur 6mm | 150x1330
 | Tasseau de pin
 | 40x40 (on a pris 38x38) | 2040
 | Ce qu'on a acheté :
 | Matériau | Quantité | Epaisseur | Largeur | Longueur |  | Surface totale (mm²) | Surface totale (cm²)
Plaques | Contreplaqué | 2 | 5 | 800 | 800 |  | 1280000 | 12800
Plaques | Agglo (pour faire du 30mm) | 2 | 15 | 600 | 1200 |  | 1440000 | 14400
Plaques | Agglo | 1 | 15 | 600 | 800 |  | 480000 | 4800
Plaques | Agglo couvert (blanc) pour faire du 22 | 2 | 18 | 500 | 1250 |  | 1250000 | 12500
Plaques | Agglo couvert (blanc) pour faire du 22 | 2 | 18 | 600 | 1250 |  | 1500000 | 15000
Tasseau | Pin | 1 | 38 | 38 | 2400
