Coupe-de-France-de-robotiques/tournament-ggdrive/Ressources - matériel/Matériel/Aire de jeu/Réalisation table.xlsx

 |  |  |  |  | ! VRAIES DIMENSIONS SUR LE PLAN !
Ensemble | Code | Nom | Nombre | Matériaux | Epaisseur | Largeur | Longueur | Acheté | Tracé | Découpé | Assemblé | Modif
Balance W | W1 | Armature | 1 | Pin | 40 | 40 | 2400 | TRUE | TRUE | TRUE | FALSE | 38*38*2400
 | W2 | Pivot | 1 | Pin | 40 | 40 | 44 | TRUE | TRUE | TRUE | FALSE
 | W3.1 | Balance | 1 | Acier | M8 |  | 400 | TRUE | TRUE | TRUE |  | 8ecrous+4rondelles
 | W3 | Plateau | 2 | Agglo | 15 | 220 | 422 | TRUE | FALSE | FALSE | FALSE
 | W4 | Rebord |  | Pin | 5 |  |  | TRUE | FALSE | FALSE | FALSE
 | W5 | Corde | 4 | Corde |  |  | 1 | TRUE | FALSE | FALSE | FALSE
 | W6 | Axe |  | Acier | 8 |  | 124 | TRUE | TRUE | TRUE | FALSE
 | W7 | Séparation | 2 | (plexi) | 5 | 275 | 422 | TRUE | FALSE | FALSE | FALSE | Ctrp Bouleau
Pentes R | R1 | Bord avant | 2 | Pin | 22 | 300 | 800 | FALSE | FALSE | FALSE | FALSE
 | R2 | Pentes | 2 | Pin | 5 | 400 | 792 | TRUE | TRUE | TRUE | FALSE
 | R3 | Bord arrière | 2 | (plexi) | 6 | 150 | 1330 | equiv | FALSE | FALSE | FALSE | Ctrp Bouleau
 | R4 | Cadre | 2 | Pin | 22 | 260 | 400 | FALSE | FALSE | FALSE | FALSE
 | R5 | Rampe | 6 (3*2 rectangles) | Pin | 22 | 145 | 760 | TRUE | TRUE | FALSE | FALSE
 | R6 | Cales | 4 | Pin | 22 | 50 | 225 | TRUE | TRUE | FALSE | FALSE
Accélérateur A | A1 | Rampe | 2 | Pin | 30 | 150 | 950 | FALSE | FALSE | FALSE | FALSE | 2*15 collé
 | A2 | Rebord arrière | 2 | Pin | 22 | 135 | 685 | TRUE | TRUE | FALSE | FALSE
 | A3 | Rebord avant | 2 | (plexi) | 5 | 205 | 750 | equiv | FALSE | FALSE | FALSE | Ctrp Bouleau
 | A4 | Support avant | 2 | Pin | 15 | 80 | 165 | FALSE | FALSE | FALSE | FALSE
 | A5 | Support arrière | 2 | Pin | 22 | 80 | 195 | TRUE | TRUE | TRUE | FALSE
 | A6 | Support milieu | 2 | Pin | 15 | 35 | 80 | FALSE | FALSE | FALSE | FALSE
 | A7 | Cale palet | 4 | Pin | rayon 15 | quart cercle | 80 | FALSE | FALSE | FALSE | FALSE
 | A8 | Bloque palet | 2 | Pin | 22 | 30 | 70 | TRUE | TRUE | FALSE | FALSE
 | A9 | Cale basse | 2 | Pin | 22 | 22 | 80 | TRUE | TRUE | FALSE | FALSE
 | A10 | Plaque avant | 2 | Crtp bouleau | 5 | 80 | 155 | FALSE | FALSE | FALSE | FALSE
 | A11 | Goupille | 2 | acier | rayon 4 |  | 120 | TRUE | TRUE | TRUE | FALSE
Expérience E | E1 | Support | 1 | Aglo | 30 | 200 | 450 | equiv | FALSE | FALSE | FALSE | doublé?
 | E2 | Pieds courts | 2 | Aglo | 30 | 40 | 170 | equiv | FALSE | FALSE | FALSE | doublé?
 | E2' | Pied long | 1 | Aglo | 30 | 40 | 450 | equiv | FALSE | FALSE | FALSE | doublé?
 | E3 | Poteau | 1 | Acier | equerre 33 epaisseur 3 | 40 | 600 | TRUE | TRUE | TRUE | FALSE | 31*31
 | E4 | Liaison covalente | 1 | Velkro | male et femelle | 30 | 140 | TRUE | FALSE | FALSE | FALSE | 20*2000
Distributeur d/D | d1 | Arrière petit | 2 | Ctrp bouleau | 5 | 40 | 300 | TRUE | TRUE | TRUE | FALSE
 | d2 | Support petit | 2 | Bois | 30 | 30 | 300 | TRUE | TRUE | a coller | FALSE
 | D1 | Arrière grand | 2 | Ctrp bouleau | 5 | 110 | 600 | TRUE | TRUE | TRUE | FALSE | collé 2*15
 | D2 | Support grand | 2 | Bois | 30 | 100 | 600 | TRUE | TRUE | TRUE | FALSE | collé 2*15
Tour T | T1 | Support haut | 1 | Bois | 22 | 200 | 400 | FALSE | FALSE | FALSE | FALSE
 | T2 | Tour 1 | 1 | Bois | 22 | 200 | 1000 | FALSE | FALSE | FALSE | FALSE
 | T2' | Tour 2 | 1 | Bois | 22 | 200 | 1000 | FALSE | FALSE | FALSE | FALSE
Balise B | B1 | Bas | 6 | Bois | 22 | 122 | 122 | TRUE | FALSE | FALSE | FALSE | recup
 | B2 | Coté petit | 6 | Bois | 22 | 48 | 100 | TRUE | FALSE | FALSE | FALSE | recup
 | B3 | Coté grand | 6 | Bois | 22 | 48 | 122 | TRUE | FALSE | FALSE | FALSE | recup
