Coupe-de-France-de-robotiques/tournament-ggdrive/Méca/Bride.stl

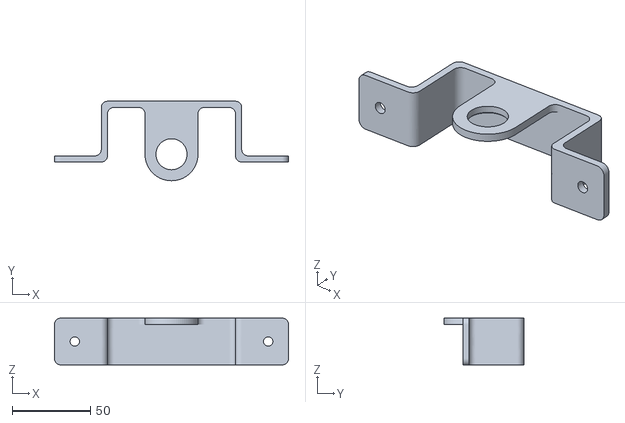
[picture p104: CAD file, 2019-09-26]
Méca/Bride.stl
150.0 x 51.0 x 30.0
