Coupe-de-France-de-robotiques/tournament-ggdrive/Ressources - matériel/Matériel/Aire de jeu/Construction de La Table.docx

Construction de La Table

Code couleur

Bois

Acier

Plexiglas

Corde

Velcro

Les Atomes

50 palets de hockey : 85 euros Decathlon à échanger avec : https://www.decathlon.fr/palet-officiel-hockey-glace-id_8392508.html

mousse de polyuréthane : environ 10 euros

Air du jeu

Tapis aire de jeu : Disponible prochainement sur le site

Balance :

W1 : Support : tasseau 40*40*2000 (tout en 1 à découper) On a pris 38x38x2400

W2 : Pivot : tasseau 40*40*44

W3.1 : Tige métallique : tige filetée d’acier 400*M8 /// 6 écrous M8 OK

W3 : Plateau : 2 plaques : 15*220*422

W4 : Rebords : 5*15*3000 (min 422 sur même planche) 5 pour 2

W5 : 4m de corde

W6 :Tige pivot : tige acier 124*8 OK on a trouvé

W7 : Plaque plexiglas : 2 plaques 422*275*5

Les pentes :

R1(bords) 22*300*800 (2 en 1)

R2(pentes) 2 plaques bois 5*400*792

R3(support) plaque plexiglas 6*150*1330 (2 complémentaires)

R4(cadre) 2*plaque bois 22*400*260

R5(rampe) 3*plaque bois 22*145*760 (6 en 3)

R6(cales) 4 plaques 22*50*225

accélérateur de particules

A1 (corps) 2*plaque de bois 30*150*950

A2 2*plaque bois 22*135*685

A3 2*plaques plexiglas 5mm 750*205

A4 2*pieces bois 15*80*165

A5 2*pieces bois 22*80*195

A6 2*pieces bois 15*35*80

A7 4*bois (extrusion quart de cercle) rayon=15 longeur 50

A8 2*bois 22*30*70

A9 2*bois 22*22*80

A10 2*bois 5*80*155

A11 2*tige acier non fileté 4mm*120 OK : on a trouvé exactement

Expérience:

Zone : E1 : grande planche bois 30*200*450

E2 : cale de zone : 2*bois epaisseur 30 / 40*170 ++ grande cale 30*40*450

E3 : Mat : acier : équerre 33*30 epaisseur 3mm, hauteur 600 OK on a pris 31x31

E4: Velkro mat : bande 30*140 (male+femelle) OK on a pris un ruban de 20x2000

Distributeur d’atomes:

petit : d1 : 2*bois 5*40*300

d2 : 2*bois 30*30*300

grand : D1 : 2*bois 5*110*600

D2 : 2*bois 30*100*600

Support balises:

Tour de contrôle:

T1 :support haut: 22*200*400

T2 et T2’ : tour : 2*plaque 22*200*1000

Balises (6)

B1 : bas : 22*122*122

B2 : coté :22*48*100

B3 : coté: 22*48*122
