Coupe-de-France-de-robotiques/tournament-ggdrive/Rendus/PSC/Organigramme.pdf

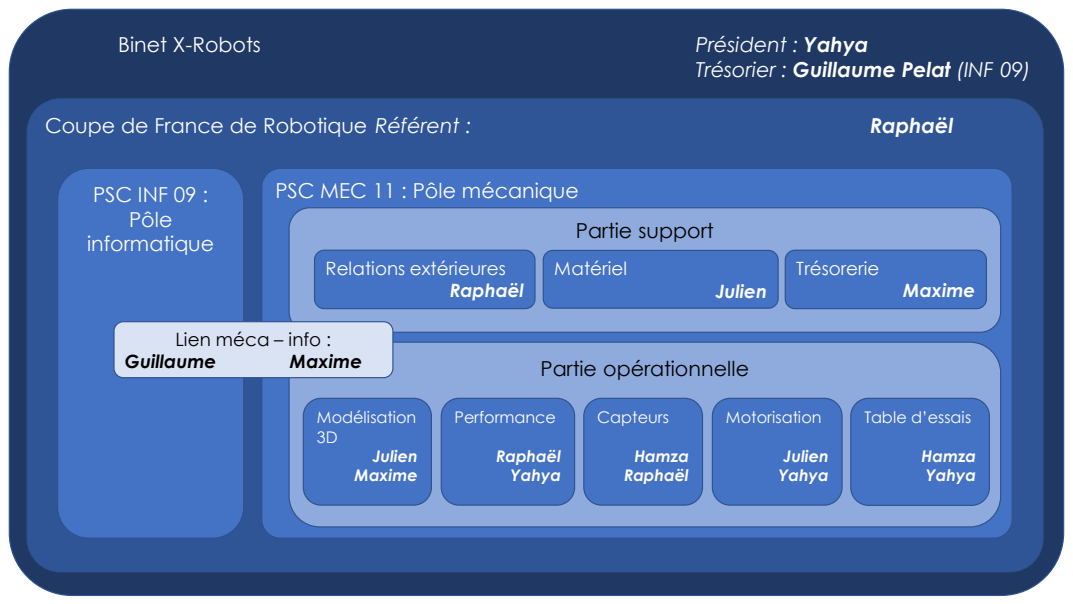
[picture p105: page 1]
Binet X-Robots; Président : Yahya; Coupe de France de Robotique Référent :; Raphaël; PSC INF 09 : Pôle informatique; Partie support; Partie opérationnelle; Relations extérieures Raphaël; Guillaume; Maxime; Matériel; Julien; Trésorerie; Modélisation 3D; Julien Maxime; Performance; Raphaël Yahya; Motorisation; Julien Yahya; Capteurs; Hamza Raphaël; Table d’essais; Hamza Yahya

Trésorier : Guillaume Pelat (INF 09)

PSC MEC 11 : Pôle mécanique

Lien méca – info :
