Coupe-de-France-de-robotiques/tournament-ggdrive/(commit log)

2019-09-26 adding tournament google drive content to git repository
    [60 - Head document.xlsx, 666 Test Plan - Lower limb table Meca.xlsx, 6666 Test Report - Lower limb table Meca.xlsx, 667 Test Plan - Lower limb table Soft.ods, 667 Test Result - Lower limb table Soft.ods, Bride.stl, Budget (revue RMO + RHE).xlsx, Budget V2.0.xlsx]
2019-09-26 adding tournament google drive files to git repository
    [60 - Head document.xlsx, 666 Test Plan - Lower limb table Meca.xlsx, 6666 Test Report - Lower limb table Meca.xlsx, 667 Test Plan - Lower limb table Soft.ods, 667 Test Result - Lower limb table Soft.ods, Budget (revue RMO + RHE).xlsx, Budget V2.0.xlsx, Budget V2.1.xlsx]
